derEchteJan/keyboards/6x5-ortho-v1/readme.md

# 6x5 ortholinear split

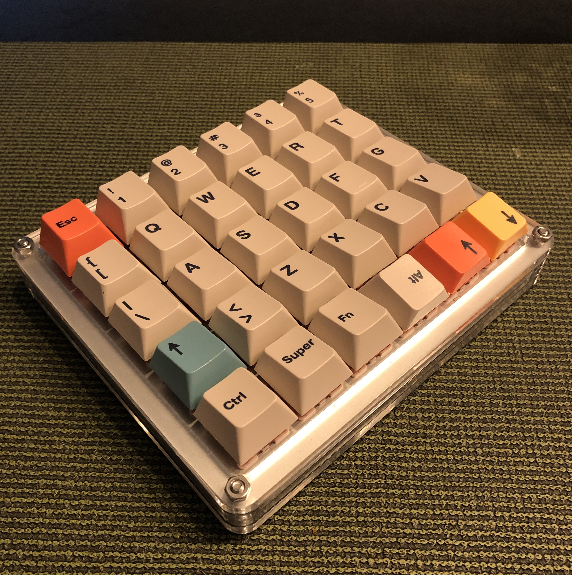
[picture p1: 6x5-ortho-v1/bort.jpeg]


# Notes

### Plate layout:
 
6 x 5 ortholinear

### Switch cuts:

plate holes (mx): 14.0 x 14.0 mm
distance: 19.05 mm (horizontal and vertical)

### Switch base area:

horizontal:     5 x 19.05 + 14 = 109.25
vertical:       4 x 19.05 + 14 =  90.20

### PCB size:

 = 114.3 x 95.25 mm
 cr: 2.4 mm
 -> rounded down for case measurements
	= 115 x 96 mm

### Case dimension:
 -> inner diameter = pcb + 2mm -> 117x98
 -> outter diameter = inner + 2x 6 mm side walls = 129x110

### Machine calibration (Epilog Fusion Pro):
 -> hole diameters: -0.35 mm
 -> positions shifted by: +0.175 mm
