derEchteJan/keyboards/brudiboard-v1/readme.md

# Brudiboard

work in progress

### Dimensions

 - tkl pcb:   119.10 x 347.70 mm
 - tkl plate: 121.10 x 347.70 mm (h + 2mm)
 - frl pcb:    95.25 x 347.70 mm
 - frl plate:  97.25 x 347.70 mm (h + 2mm)

### Key count
 
| Row: | Keys: | Sockets: |
|---|---|---|
| Func: | 16 | 16 |
| Num: | 17 (+1) | 17 (+2)  |
| tab: | 17 | 17 |
| caps: | 13 | 13 (+1)  |
| shift:  | 13 (+2) | 13 (+4)  |
| bottom: | 11 (+1) | 11 (+9)  |

- TKL: 87 (+4) keys = 83.65%, 87 - 103 Sockets
- FRL: 71 (+4) keys = 68.26%, 71 - 87  Sockets

### Required build materials

Amount for TKL (FRL in brackets)

- acrylic sheets 3,4,5mm
- hotswap sockets 103x (71x)
- 1N4148 diode 91x (75x)
- raspi pico
- usb breakout board
- switches 87-91x (71-75x)
- plate 1.5mm, material of choice
- wire for usb 28-30 AWG
- hex screw M3 20mm 4x, M3 15mm 4x, M2 10mm 2x
- 4mm M3 inserts 8x, 4mm M2 inserts 2x
- 8cm gasket strips 2mm 7x
 
### TODO
 - small stab holes can be enlarged
 - firmware:
   - minus has the kp_minus bound
   - up and down arrow are interchanged in via
   - spacebar is bound to MO(1)
