derEchteJan/keyboards/brudiboard-v1/case/readme.md

Adjustments:

- general path offset +0.35mm
- small screw radius offset: +0.5mm
