derEchteJan/keyboards/brudiboard-v1/layout/bb-layout.png

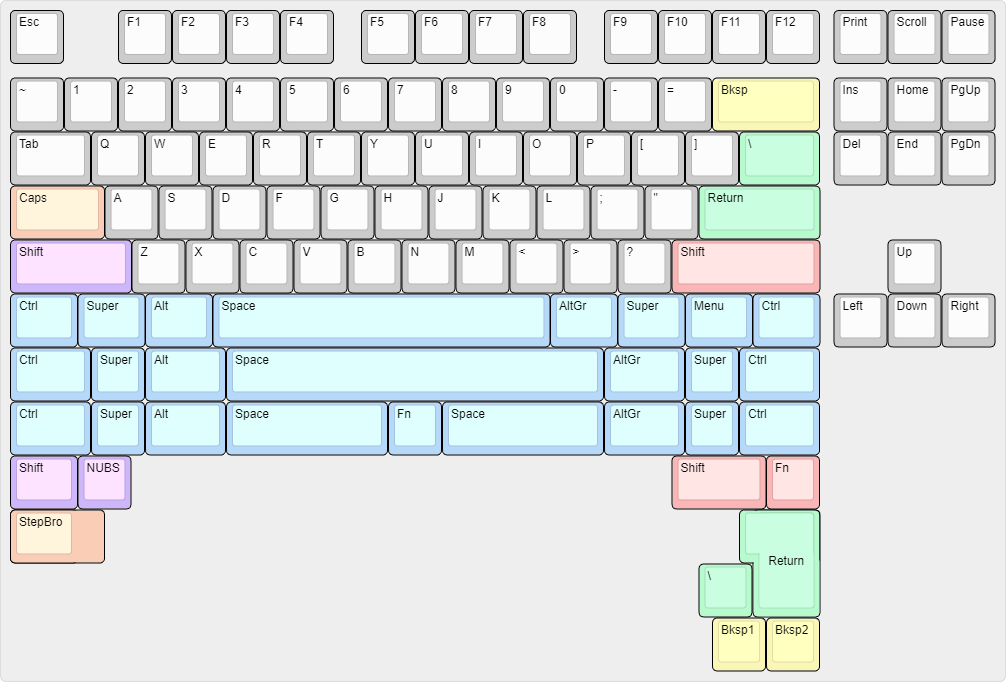
brudiboard-v1/layout/bb-layout.png
