derEchteJan/keyboards/brudiboard-v1/layout/bb-matrix.png

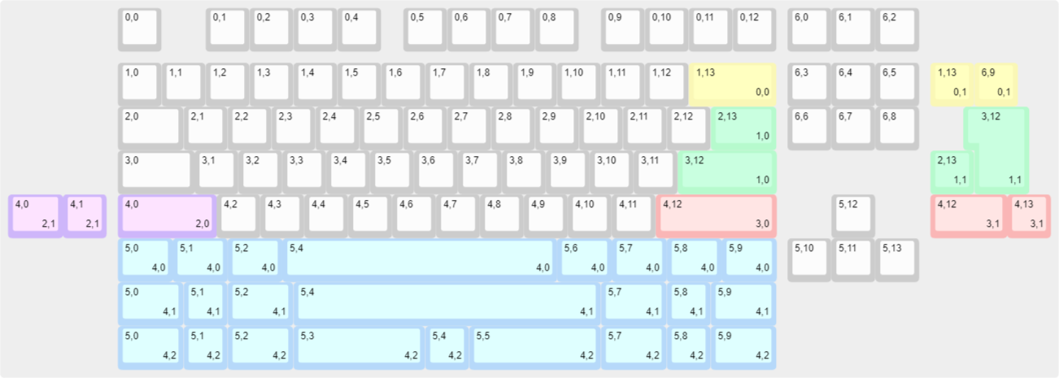
brudiboard-v1/layout/bb-matrix.png
