derEchteJan/keyboards/cycle7-plate/cycle7-plate.png

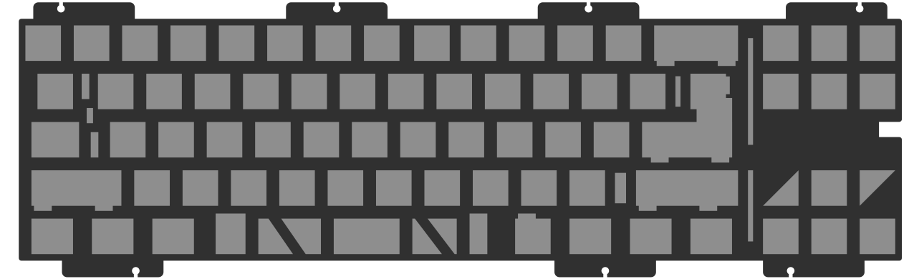
cycle7-plate/cycle7-plate.png
