derEchteJan/keyboards/brudiboard-v1/plate/production/bb-plate-frl-R12.dxf

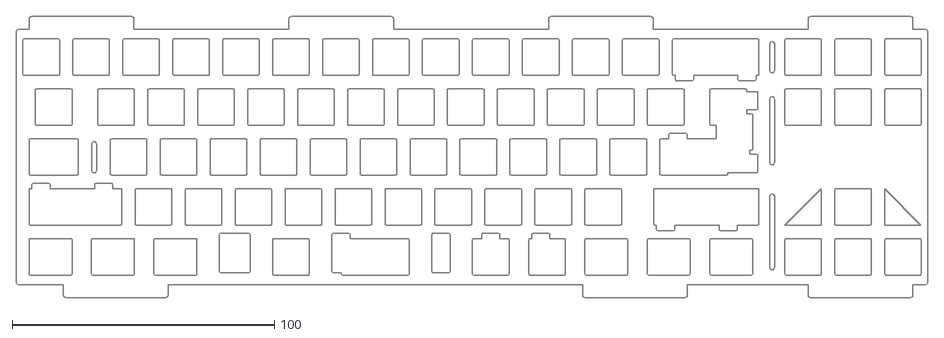
[picture p6: CAD file, 2024-05-14]
brudiboard-v1/plate/production/bb-plate-frl-R12.dxf
347.6 x 107.3
