derEchteJan/keyboards/brudiboard-v1/plate/production/lto/03-plate-tkl-wkl-R12.dxf

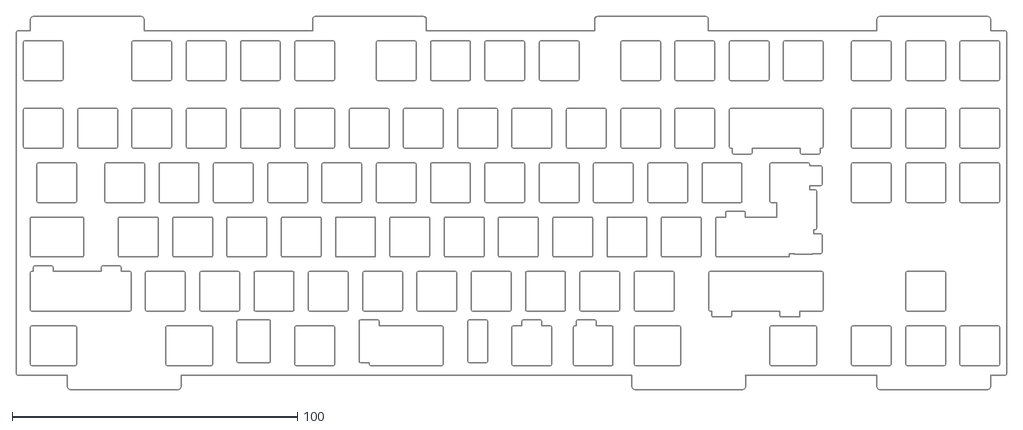
[picture p7: CAD file, 2024-05-24]
brudiboard-v1/plate/production/lto/03-plate-tkl-wkl-R12.dxf
347.6 x 131.0
