derEchteJan/keyboards/6x5-ortho-v1/case/plate-R12.dxf

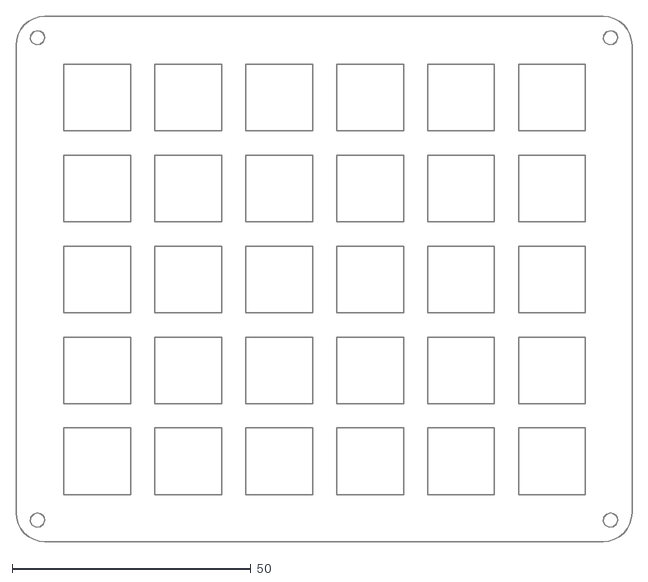
[picture p8: CAD file, 2024-03-21]
6x5-ortho-v1/case/plate-R12.dxf
129.0 x 110.0
