derEchteJan/keyboards/brudiboard-v1/plate/production/bb-plate-tkl-R12.dxf

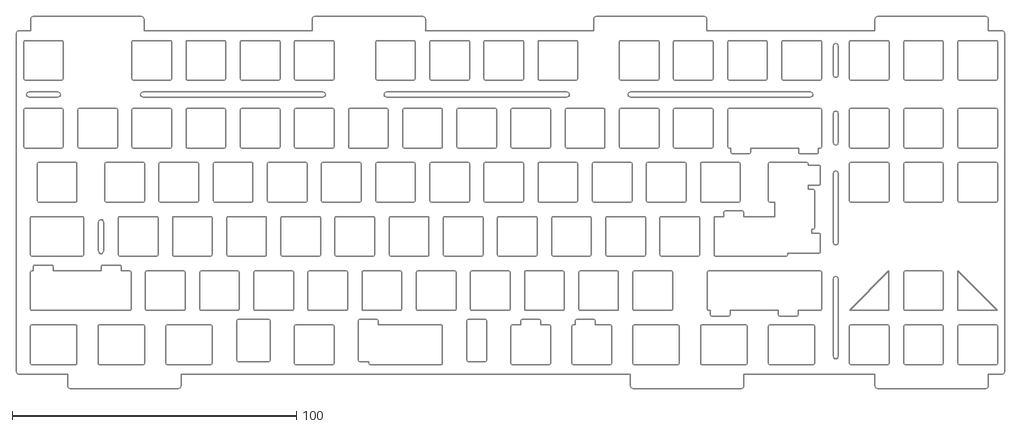
[picture p9: CAD file, 2024-05-14]
brudiboard-v1/plate/production/bb-plate-tkl-R12.dxf
347.6 x 131.0
