derEchteJan/keyboards/6x5-ortho-v1/case/plate-NOLWPL-UTF8-R14.dxf

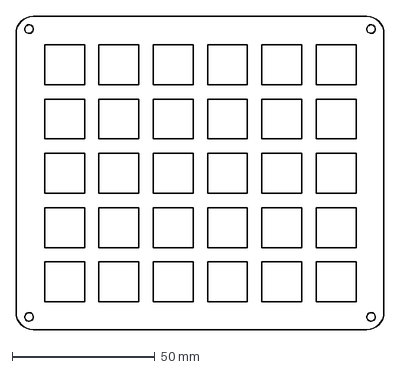
[picture p11: CAD file, 2024-03-21]
6x5-ortho-v1/case/plate-NOLWPL-UTF8-R14.dxf
129.0 x 110.0 mm
