derEchteJan/keyboards/brudiboard-v1/plate/production/lto/02-plate-tkl-R12.dxf

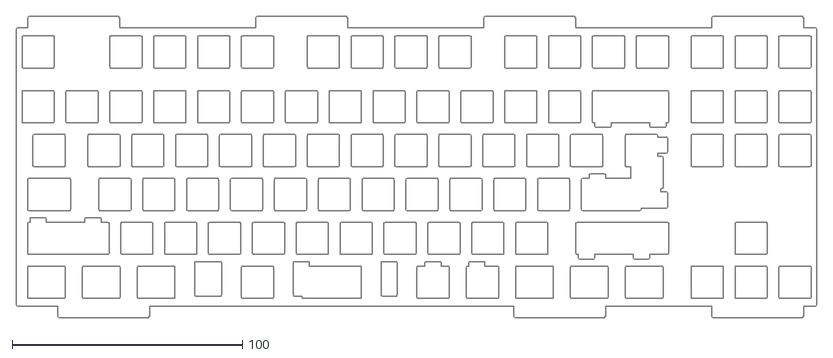
[picture p12: CAD file, 2024-05-14]
brudiboard-v1/plate/production/lto/02-plate-tkl-R12.dxf
347.6 x 131.0
