derEchteJan/keyboards/brudiboard-v1/pcb/bb-pcb-v1/bb-pcb-v1.kicad_pcb

## KiCad design brudiboard-v1/pcb/bb-pcb-v1/bb-pcb-v1.kicad_pcb (2024-10-30)

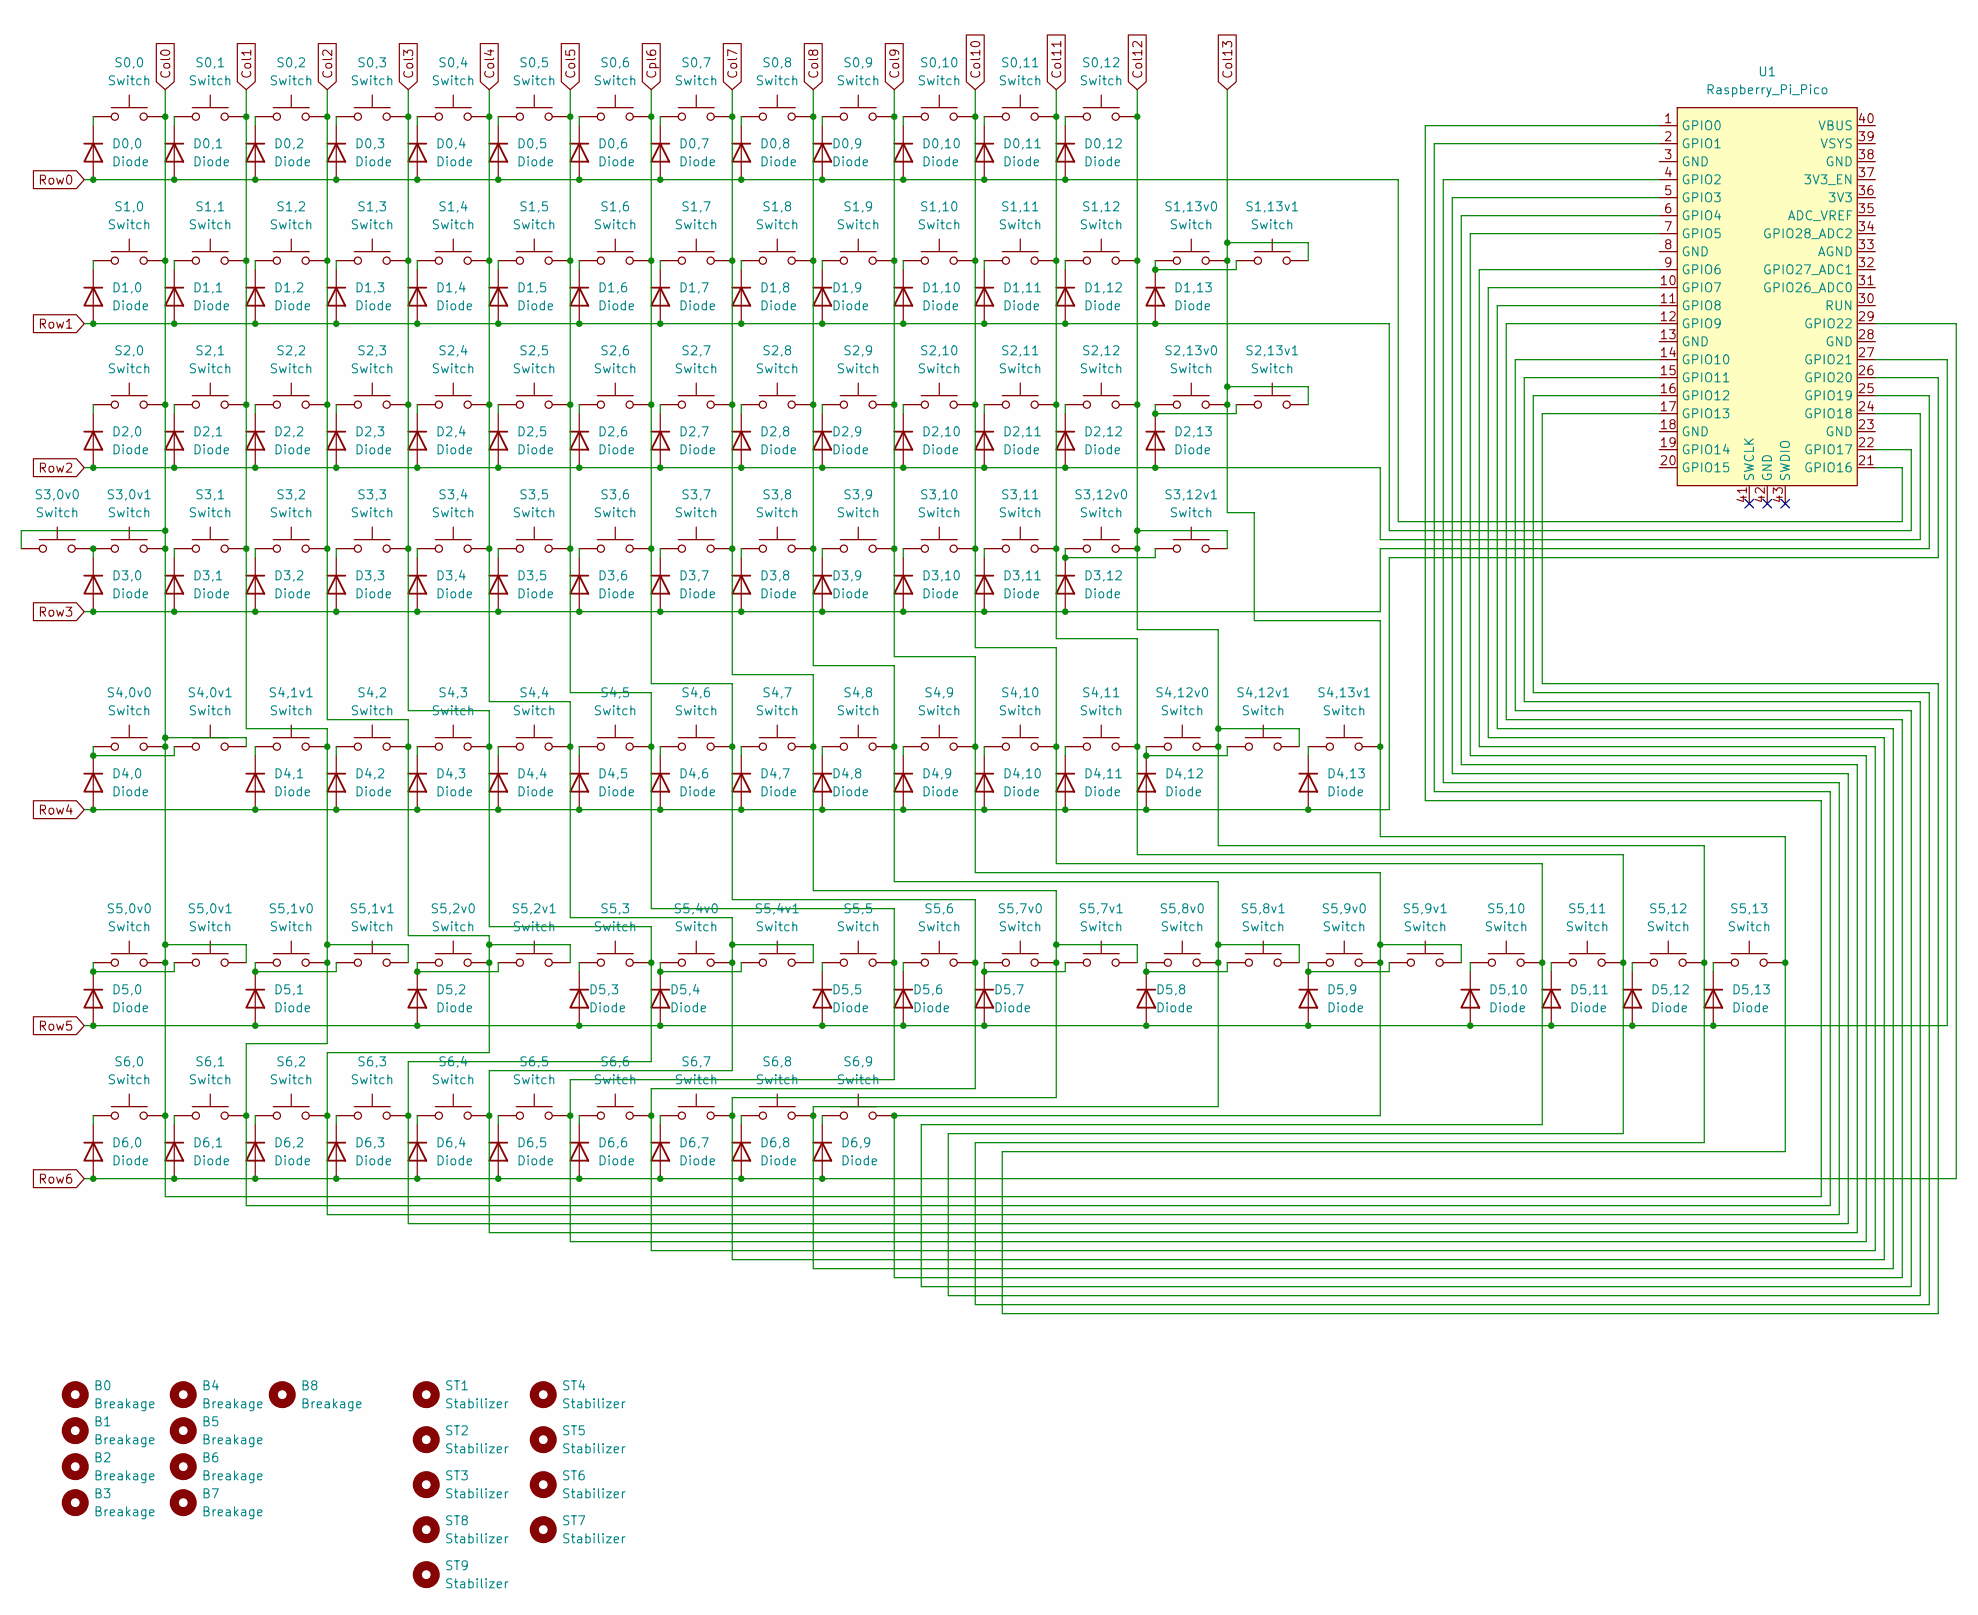
[picture p13: schematic bb-pcb-v1.kicad_sch]

Parts:
B0, B1, B2, B3, B4, B5, B6, B7, B8: Breakage; breakage
D0,0, D0,1, D0,2, D0,3, D0,4, D0,5, D0,6, D0,7, D0,8, D0,9, D0,10, D0,11, D0,12, D1,0, D1,1, D1,2, D1,3, D1,4, D1,5, D1,6, D1,7, D1,8, D1,9, D1,10, D1,11, D1,12, D1,13, D2,0, D2,1, D2,2, D2,3, D2,4, D2,5, D2,6, D2,7, D2,8, D2,9, D2,10, D2,11, D2,12, D2,13, D3,0, D3,1, D3,2, D3,3, D3,4, D3,5, D3,6, D3,7, D3,8, D3,9, D3,10, D3,11, D3,12, D4,0, D4,1, D4,2, D4,3, D4,4, D4,5, D4,6, D4,7, D4,8, D4,9, D4,10, D4,11, D4,12, D4,13, D5,0, D5,1, D5,2, D5,3, D5,4, D5,5, D5,6, D5,7, D5,8, D5,9, D5,10, D5,11, D5,12, D5,13, D6,0, D6,1, D6,2, D6,3, D6,4, D6,5, D6,6, D6,7, D6,8, D6,9: Diode; Diode_DO-35
S0,0, S0,1, S0,2, S0,3, S0,4, S0,5, S0,6, S0,7, S0,8, S0,9, S0,10, S0,11, S0,12, S1,0, S1,1, S1,2, S1,3, S1,4, S1,5, S1,6, S1,7, S1,8, S1,9, S1,10, S1,11, S1,12, S1,13v1, S2,1, S2,2, S2,3, S2,4, S2,5, S2,6, S2,7, S2,8, S2,9, S2,10, S2,11, S2,12, S2,13v1, S3,0v1, S3,1, S3,2, S3,3, S3,4, S3,5, S3,6, S3,7, S3,8, S3,9, S3,10, S3,11, S4,0v1, S4,1v1, S4,2, S4,3, S4,4, S4,5, S4,6, S4,7, S4,8, S4,9, S4,10, S4,11, S4,12v1, S4,13v1, S5,1v1, S5,8v1, S5,10, S5,11, S5,12, S5,13, S6,0, S6,1, S6,2, S6,3, S6,4, S6,5, S6,6, S6,7, S6,8, S6,9: Switch; Hotswap_MX_1.00u
S1,13v0: Switch; Hotswap_MX_2.00u
S2,0, S2,13v0, S5,0v1, S5,2v1, S5,7v1, S5,9v1: Switch; Hotswap_MX_1.50u
S3,0v0: Switch; Hotswap_MX_1.75u
S3,12v0, S4,0v0: Switch; Hotswap_MX_2.25u
S3,12v1: Switch; Hotswap_MX_ISOEnter
S4,12v0: Switch; Hotswap_MX_2.75u
S5,0v0, S5,1v0, S5,2v0, S5,6, S5,7v0, S5,8v0, S5,9v0: Switch; Hotswap_MX_1.25u
S5,3, S5,5: Switch; Hotswap_MX_3.00u
S5,4v0: Switch; Hotswap_MX_6.25u
S5,4v1: Switch; Hotswap_MX_7.00u
ST1, ST2, ST3, ST8, ST9: Stabilizer; Stabilizer_MX_2.00u_Exact
ST4: Stabilizer; Stabilizer_MX_6.25u_Exact
ST5: Stabilizer; Stabilizer_MX_7.00u_Exact
ST6: Stabilizer; Stabilizer_MX_3.00u_Exact_Left
ST7: Stabilizer; Stabilizer_MX_3.00u_Exact_Right
U1: Raspberry_Pi_Pico; Raspberry_Pi_Pico_Modified

Connections:
Col0: S0,0.2, S1,0.2, S2,0.2, S3,0v0.1, S3,0v1.2, S4,0v0.2, S4,0v1.2, S5,0v0.2, S5,0v1.2, S6,0.2, U1.1 (GPIO0)
Col1: S0,1.2, S1,1.2, S2,1.2, S3,1.2, S4,1v1.2, S5,1v0.2, S5,1v1.2, S6,1.2, U1.2 (GPIO1)
Col2: S0,2.2, S1,2.2, S2,2.2, S3,2.2, S4,2.2, S5,2v0.2, S5,2v1.2, S6,2.2, U1.4 (GPIO2)
Col3: S0,3.2, S1,3.2, S2,3.2, S3,3.2, S4,3.2, S5,3.2, S6,3.2, U1.5 (GPIO3)
Col4: S0,4.2, S1,4.2, S2,4.2, S3,4.2, S4,4.2, S5,4v0.2, S5,4v1.2, S6,4.2, U1.6 (GPIO4)
Col5: S0,5.2, S1,5.2, S2,5.2, S3,5.2, S4,5.2, S5,5.2, S6,5.2, U1.7 (GPIO5)
Col7: S0,7.2, S1,7.2, S2,7.2, S3,7.2, S4,7.2, S5,7v0.2, S5,7v1.2, S6,7.2, U1.10 (GPIO7)
Col8: S0,8.2, S1,8.2, S2,8.2, S3,8.2, S4,8.2, S5,8v0.2, S5,8v1.2, S6,8.2, U1.11 (GPIO8)
Col9: S0,9.2, S1,9.2, S2,9.2, S3,9.2, S4,9.2, S5,9v0.2, S5,9v1.2, S6,9.2, U1.12 (GPIO9)
Col10: S0,10.2, S1,10.2, S2,10.2, S3,10.2, S4,10.2, S5,10.2, U1.14 (GPIO10)
Col11: S0,11.2, S1,11.2, S2,11.2, S3,11.2, S4,11.2, S5,11.2, U1.15 (GPIO11)
Col12: S0,12.2, S1,12.2, S2,12.2, S3,12v0.2, S3,12v1.2, S4,12v0.2, S4,12v1.2, S5,12.2, U1.16 (GPIO12)
Col13: S1,13v0.2, S1,13v1.2, S2,13v0.2, S2,13v1.2, S4,13v1.2, S5,13.2, U1.17 (GPIO13)
Cpl6: S0,6.2, S1,6.2, S2,6.2, S3,6.2, S4,6.2, S5,6.2, S6,6.2, U1.9 (GPIO6)
unnamed: D0,0.1 (K), S0,0.1
unnamed: D0,1.1 (K), S0,1.1
unnamed: D0,2.1 (K), S0,2.1
unnamed: D0,3.1 (K), S0,3.1
unnamed: D0,4.1 (K), S0,4.1
unnamed: D0,5.1 (K), S0,5.1
unnamed: D0,6.1 (K), S0,6.1
unnamed: D0,7.1 (K), S0,7.1
unnamed: D0,8.1 (K), S0,8.1
unnamed: D0,9.1 (K), S0,9.1
unnamed: D0,10.1 (K), S0,10.1
unnamed: D0,11.1 (K), S0,11.1
unnamed: D0,12.1 (K), S0,12.1
unnamed: D1,0.1 (K), S1,0.1
unnamed: D1,1.1 (K), S1,1.1
unnamed: D1,2.1 (K), S1,2.1
unnamed: D1,3.1 (K), S1,3.1
unnamed: D1,4.1 (K), S1,4.1
unnamed: D1,5.1 (K), S1,5.1
unnamed: D1,6.1 (K), S1,6.1
unnamed: D1,7.1 (K), S1,7.1
unnamed: D1,8.1 (K), S1,8.1
unnamed: D1,9.1 (K), S1,9.1
unnamed: D1,10.1 (K), S1,10.1
unnamed: D1,11.1 (K), S1,11.1
unnamed: D1,12.1 (K), S1,12.1
unnamed: D1,13.1 (K), S1,13v0.1, S1,13v1.1
unnamed: D2,0.1 (K), S2,0.1
unnamed: D2,1.1 (K), S2,1.1
unnamed: D2,2.1 (K), S2,2.1
unnamed: D2,3.1 (K), S2,3.1
unnamed: D2,4.1 (K), S2,4.1
unnamed: D2,5.1 (K), S2,5.1
unnamed: D2,6.1 (K), S2,6.1
unnamed: D2,7.1 (K), S2,7.1
unnamed: D2,8.1 (K), S2,8.1
unnamed: D2,9.1 (K), S2,9.1
unnamed: D2,10.1 (K), S2,10.1
unnamed: D2,11.1 (K), S2,11.1
unnamed: D2,12.1 (K), S2,12.1
unnamed: D2,13.1 (K), S2,13v0.1, S2,13v1.1
unnamed: D3,0.1 (K), S3,0v0.2, S3,0v1.1
unnamed: D3,1.1 (K), S3,1.1
unnamed: D3,2.1 (K), S3,2.1
unnamed: D3,3.1 (K), S3,3.1
unnamed: D3,4.1 (K), S3,4.1
unnamed: D3,5.1 (K), S3,5.1
unnamed: D3,6.1 (K), S3,6.1
unnamed: D3,7.1 (K), S3,7.1
unnamed: D3,8.1 (K), S3,8.1
unnamed: D3,9.1 (K), S3,9.1
unnamed: D3,10.1 (K), S3,10.1
unnamed: D3,11.1 (K), S3,11.1
unnamed: D3,12.1 (K), S3,12v0.1, S3,12v1.1
unnamed: D4,0.1 (K), S4,0v0.1, S4,0v1.1
unnamed: D4,1.1 (K), S4,1v1.1
unnamed: D4,2.1 (K), S4,2.1
unnamed: D4,3.1 (K), S4,3.1
unnamed: D4,4.1 (K), S4,4.1
unnamed: D4,5.1 (K), S4,5.1
unnamed: D4,6.1 (K), S4,6.1
unnamed: D4,7.1 (K), S4,7.1
unnamed: D4,8.1 (K), S4,8.1
unnamed: D4,9.1 (K), S4,9.1
unnamed: D4,10.1 (K), S4,10.1
unnamed: D4,11.1 (K), S4,11.1
unnamed: D4,12.1 (K), S4,12v0.1, S4,12v1.1
unnamed: D4,13.1 (K), S4,13v1.1
unnamed: D5,0.1 (K), S5,0v0.1, S5,0v1.1
unnamed: D5,1.1 (K), S5,1v0.1, S5,1v1.1
unnamed: D5,2.1 (K), S5,2v0.1, S5,2v1.1
unnamed: D5,3.1 (K), S5,3.1
unnamed: D5,4.1 (K), S5,4v0.1, S5,4v1.1
unnamed: D5,5.1 (K), S5,5.1
unnamed: D5,6.1 (K), S5,6.1
unnamed: D5,7.1 (K), S5,7v0.1, S5,7v1.1
unnamed: D5,8.1 (K), S5,8v0.1, S5,8v1.1
unnamed: D5,9.1 (K), S5,9v0.1, S5,9v1.1
unnamed: D5,10.1 (K), S5,10.1
unnamed: D5,11.1 (K), S5,11.1
unnamed: D5,12.1 (K), S5,12.1
unnamed: D5,13.1 (K), S5,13.1
unnamed: D6,0.1 (K), S6,0.1
unnamed: D6,1.1 (K), S6,1.1
unnamed: D6,2.1 (K), S6,2.1
unnamed: D6,3.1 (K), S6,3.1
unnamed: D6,4.1 (K), S6,4.1
unnamed: D6,5.1 (K), S6,5.1
unnamed: D6,6.1 (K), S6,6.1
unnamed: D6,7.1 (K), S6,7.1
unnamed: D6,8.1 (K), S6,8.1
unnamed: D6,9.1 (K), S6,9.1
Row0: D0,0.2 (A), D0,1.2 (A), D0,2.2 (A), D0,3.2 (A), D0,4.2 (A), D0,5.2 (A), D0,6.2 (A), D0,7.2 (A), D0,8.2 (A), D0,9.2 (A), D0,10.2 (A), D0,11.2 (A), D0,12.2 (A), U1.21 (GPIO16)
Row1: D1,0.2 (A), D1,1.2 (A), D1,2.2 (A), D1,3.2 (A), D1,4.2 (A), D1,5.2 (A), D1,6.2 (A), D1,7.2 (A), D1,8.2 (A), D1,9.2 (A), D1,10.2 (A), D1,11.2 (A), D1,12.2 (A), D1,13.2 (A), U1.22 (GPIO17)
Row2: D2,0.2 (A), D2,1.2 (A), D2,2.2 (A), D2,3.2 (A), D2,4.2 (A), D2,5.2 (A), D2,6.2 (A), D2,7.2 (A), D2,8.2 (A), D2,9.2 (A), D2,10.2 (A), D2,11.2 (A), D2,12.2 (A), D2,13.2 (A), U1.24 (GPIO18)
Row3: D3,0.2 (A), D3,1.2 (A), D3,2.2 (A), D3,3.2 (A), D3,4.2 (A), D3,5.2 (A), D3,6.2 (A), D3,7.2 (A), D3,8.2 (A), D3,9.2 (A), D3,10.2 (A), D3,11.2 (A), D3,12.2 (A), U1.25 (GPIO19)
Row4: D4,0.2 (A), D4,1.2 (A), D4,2.2 (A), D4,3.2 (A), D4,4.2 (A), D4,5.2 (A), D4,6.2 (A), D4,7.2 (A), D4,8.2 (A), D4,9.2 (A), D4,10.2 (A), D4,11.2 (A), D4,12.2 (A), D4,13.2 (A), U1.26 (GPIO20)
Row5: D5,0.2 (A), D5,1.2 (A), D5,2.2 (A), D5,3.2 (A), D5,4.2 (A), D5,5.2 (A), D5,6.2 (A), D5,7.2 (A), D5,8.2 (A), D5,9.2 (A), D5,10.2 (A), D5,11.2 (A), D5,12.2 (A), D5,13.2 (A), U1.27 (GPIO21)
Row6: D6,0.2 (A), D6,1.2 (A), D6,2.2 (A), D6,3.2 (A), D6,4.2 (A), D6,5.2 (A), D6,6.2 (A), D6,7.2 (A), D6,8.2 (A), D6,9.2 (A), U1.29 (GPIO22)

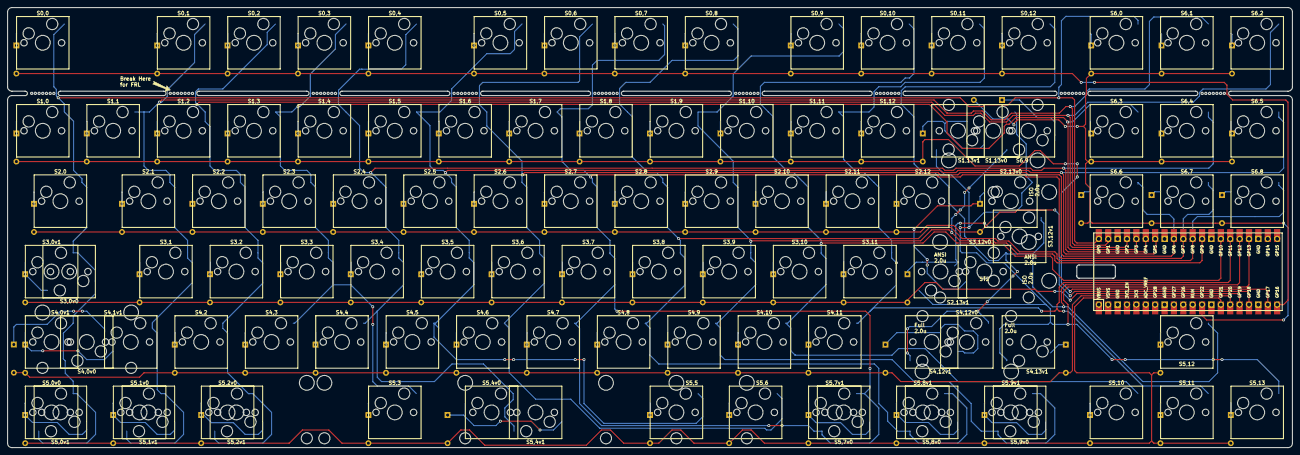
[picture p14: board bb-pcb-v1.kicad_pcb from above]

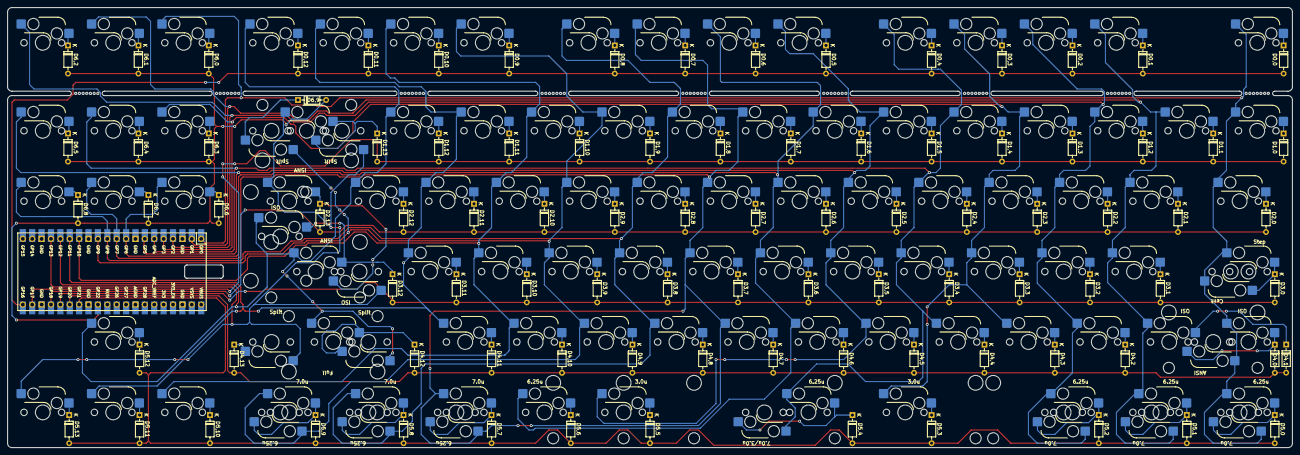
[picture p15: board bb-pcb-v1.kicad_pcb from below]

Board: 2 copper layers, 347.7 x 119.1 mm, 216 parts (93 on the bottom side), 113 nets.
