derEchteJan/keyboards/(commit log)

2024-02-20 cleanup, re-add calibration files
2024-03-02 cycle7-plate initial files
2024-03-10 brudiboard-v1 plate and pcb finished
    [bb-pcb-v1.kicad_pcb, bb-pcb-v1.kicad_sch, bb-plate.dxf]
2024-03-11 brudiboard-v1 frl case top view added
2024-03-13 brudiboard-v1 pcb v1 finalized and exported
    [bb-pcb-v1-B_Cu.gbl, bb-pcb-v1-B_Mask.gbs, bb-pcb-v1-B_Paste.gbp, bb-pcb-v1-B_Silkscreen.gbo, bb-pcb-v1-Edge_Cuts.gm1, bb-pcb-v1-F_Cu.gtl, bb-pcb-v1-F_Mask.gts, bb-pcb-v1-F_Paste.gtp]
2024-03-21 brudiboard-v1 case design modifiactions + plate production files
    [bb-plate-frl-NOFLEX-R12.dxf, bb-plate-frl-R12.dxf, bb-plate-tkl-NOFLEX-R12.dxf, bb-plate-tkl-R12.dxf, bb-plate.dxf, plate-LWPL-UTF8-R14.dxf, plate-NOLWPL-UTF8-R14.dxf, plate-R12.dxf]
2024-05-14 brudiboard-v1 case production files + pcb rev 3
    [bb-pcb-v1-B_Cu.gbl, bb-pcb-v1-B_Mask.gbs, bb-pcb-v1-B_Paste.gbp, bb-pcb-v1-B_Silkscreen.gbo, bb-pcb-v1-Edge_Cuts.gm1, bb-pcb-v1-F_Cu.gtl, bb-pcb-v1-F_Mask.gts, bb-pcb-v1-F_Paste.gtp]
2024-05-15 brudiboard-v1 case sketch adjustments
2024-05-21 brudiboard-v1 case adjustments
2024-05-24 brudiboard-v1 case adjustments and firmware build added
    [bb-plate-tkl-nocuts-wkl-R12.dxf]
2024-05-27 brudiboard-v1 matrix adjusted, deprecated gerbers deleted
    [bb-pcb-v1-B_Cu.gbl, bb-pcb-v1-B_Mask.gbs, bb-pcb-v1-B_Paste.gbp, bb-pcb-v1-B_Silkscreen.gbo, bb-pcb-v1-Edge_Cuts.gm1, bb-pcb-v1-F_Cu.gtl, bb-pcb-v1-F_Mask.gts, bb-pcb-v1-F_Paste.gtp]
2024-05-27 brudiboard-v1 added special edition pcb
2024-05-29 brudiboard-v1 plate produciton files and tkl sideview added
2024-06-11 brudiboard-v1 corrected both adjusted case templates
2024-06-18 brudiboard-v1 lto order files
    [01-plate-frl-R12.dxf, 02-plate-tkl-R12.dxf]
2024-10-30 plate changes prod
    [bb-plate-frl-R12.dxf, bb-plate-frl-nocuts-R12.dxf, bb-plate-tkl-R12.dxf, bb-plate-tkl-nocuts-R12.dxf, bb-plate-tkl-nocuts-wkl-R12.dxf]
2024-10-30 brudiboard-v1: generated gerbers without fillzones front and back
    [bb-pcb-v1.kicad_pcb]
2024-12-21 brudiboard-v1 db2 frl adjustments
    [03-plate-tkl-wkl-R12.dxf]
2025-02-18 brudiboard-v1 adjusted screw holes FRL
2025-02-19 brudiboard-v1 adjusted screw holes tkl
